UCSD-ECEMAE-148/148-winter-2025-final-project-team-11/markdown/image-6.png

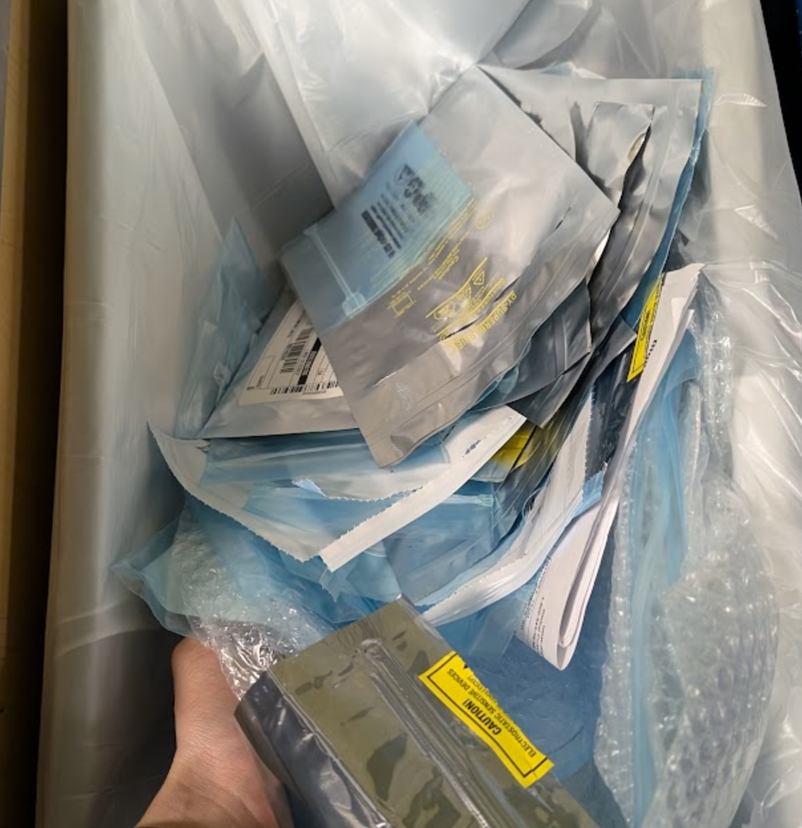
markdown/image-6.png
