UCSD-ECEMAE-148/148-winter-2025-final-project-team-11/markdown/image-10.png

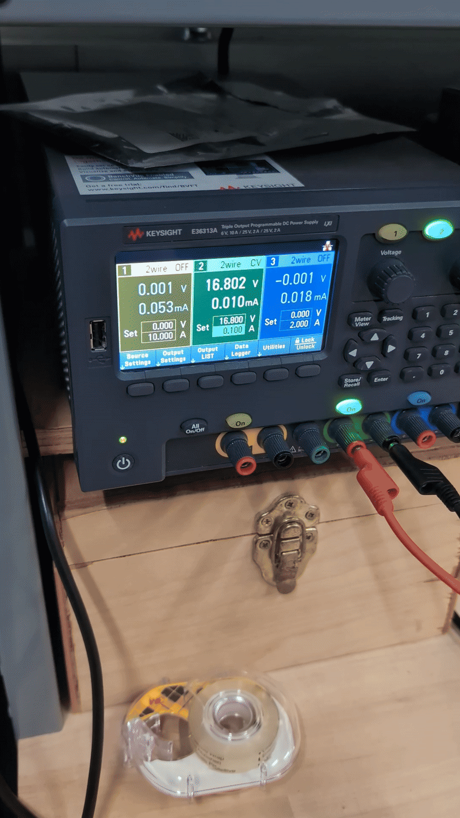
markdown/image-10.png
