UCSD-ECEMAE-148/148-winter-2025-final-project-team-11/ECE148_Mainboard_PCB/ECE148_Mainboard.kicad_pcb

## KiCad design ECE148_Mainboard_PCB/ECE148_Mainboard.kicad_pcb (2025-03-14)

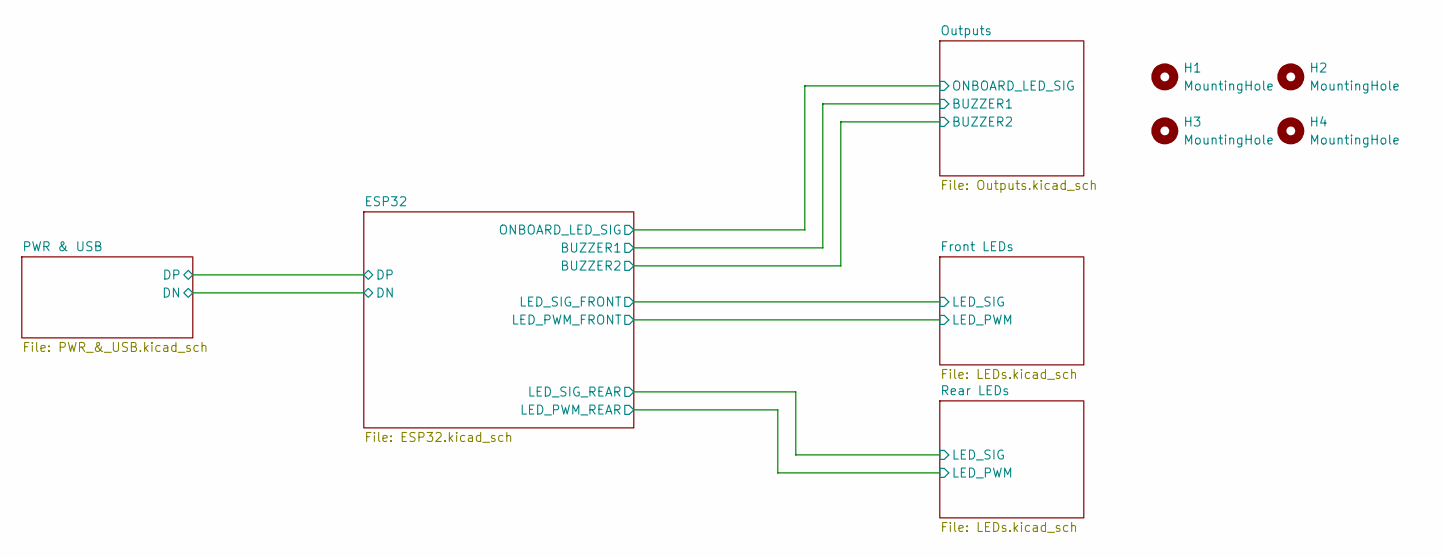
[picture p14: schematic ECE148_Mainboard.kicad_sch]

Parts:
H1, H2, H3, H4: MountingHole; MountingHole_3.2mm_M3

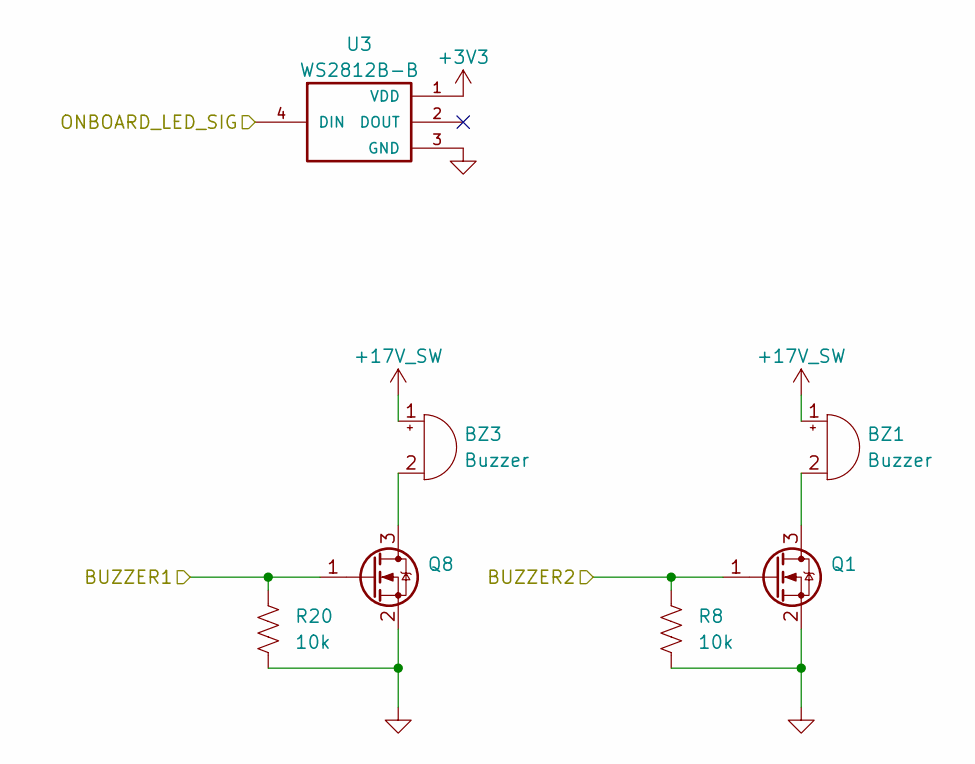
[picture p15: schematic Outputs.kicad_sch]

Parts:
BZ1, BZ3: Buzzer; Buzzer_12x9.5RM7.6
Q1, Q8: Q_NMOS_GSD; SOT-23
R8, R20: 10k; R_0402_1005Metric
U3: WS2812B-B; LED_WS2812B-B; PARTREV 5

Connections:
+3V3: U3.1 (VDD); also elsewhere on the board
+17V_SW: BZ1.1 (+), BZ3.1 (+); also elsewhere on the board
/ESP32/BUZZER1: Q8.1 (G), R20.1; also elsewhere on the board
/ESP32/BUZZER2: Q1.1 (G), R8.1; also elsewhere on the board
/ESP32/ONBOARD_LED_SIG: U3.4 (DIN); also elsewhere on the board
GND: Q1.2 (S), Q8.2 (S), R8.2, R20.2, U3.3 (GND); also elsewhere on the board
unnamed: BZ1.2 (-), Q1.3 (D)

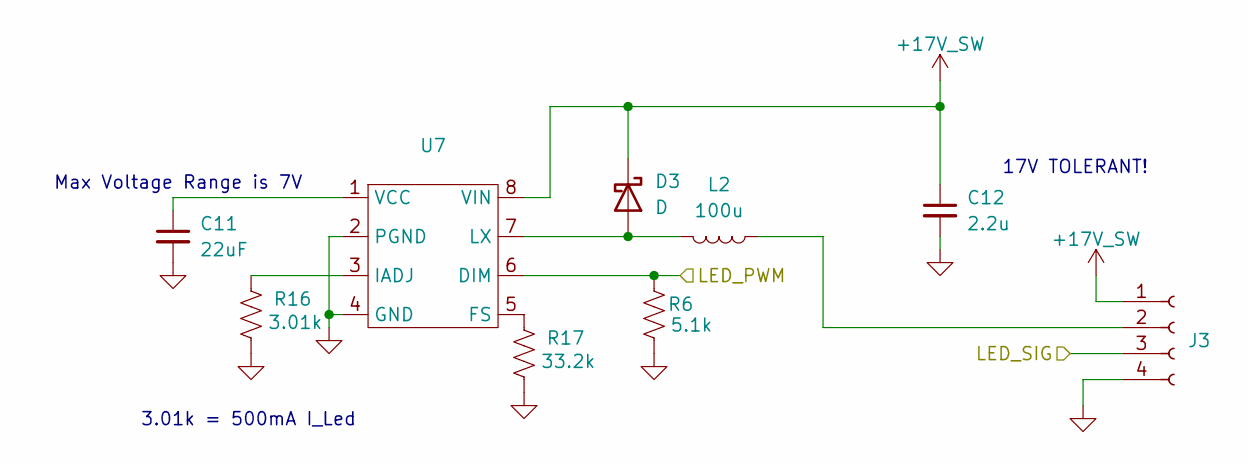
[picture p16: schematic LEDs.kicad_sch]

Parts:
C11: 22uF; C_0603_1608Metric
C12: 2.2u; C_0603_1608Metric
D3: D; D_SOD-123F
J3: Conn_01x05_Socket; JST_XH_B4B-XH-A_1x04_P2.50mm_Vertical
L2: 100u; L_Taiyo-Yuden_NR-60xx
R6: 5.1k; R_0402_1005Metric
R16: 3.01k; R_0402_1005Metric
R17: 33.2k; R_0402_1005Metric
U7: TI_SO-PowerPAD-8_ThermalVias

Connections:
+17V_SW: C12.1, D3.1 (K), J3.1, U7.8 (VIN); also elsewhere on the board
/ESP32/LED_PWM_FRONT: R6.1, U7.6 (DIM); also elsewhere on the board
/ESP32/LED_SIG_FRONT: J3.3; also elsewhere on the board
GND: C11.2, C12.2, J3.4, R6.2, R16.1, R17.1, U7.2 (PGND), U7.4 (GND), U7.9 (GND); also elsewhere on the board
unnamed: D3.2 (A), L2.2, U7.7 (LX)
unnamed: J3.2, L2.1
unnamed: R17.2, U7.5 (FS)
unnamed: R16.2, U7.3 (IADJ)
unnamed: C11.1, U7.1 (VCC)

Parts of its further copies:
C13: 22uF; C_0603_1608Metric
C14: 2.2u; C_0603_1608Metric
D4: D; D_SOD-123F
J12: Conn_01x05_Socket; JST_XH_B4B-XH-A_1x04_P2.50mm_Vertical
L3: 100u; L_Taiyo-Yuden_NR-60xx
R7: 5.1k; R_0402_1005Metric
R18: 3.01k; R_0402_1005Metric
R19: 33.2k; R_0402_1005Metric
U8: TI_SO-PowerPAD-8_ThermalVias

Connections of its further copies:
+17V_SW: C14.1, D4.1 (K), J12.1, U8.8 (VIN); also elsewhere on the board
/ESP32/LED_PWM_REAR: R7.1, U8.6 (DIM); also elsewhere on the board
/ESP32/LED_SIG_REAR: J12.3; also elsewhere on the board
GND: C13.2, C14.2, J12.4, R7.2, R18.1, R19.1, U8.2 (PGND), U8.4 (GND), U8.9 (GND); also elsewhere on the board
unnamed: D4.2 (A), L3.2, U8.7 (LX)
unnamed: J12.2, L3.1
unnamed: R19.2, U8.5 (FS)
unnamed: R18.2, U8.3 (IADJ)
unnamed: C13.1, U8.1 (VCC)

Notes on the sheet:
17V TOLERANT!
Max Voltage Range is 7V
3.01k = 500mA I_Led

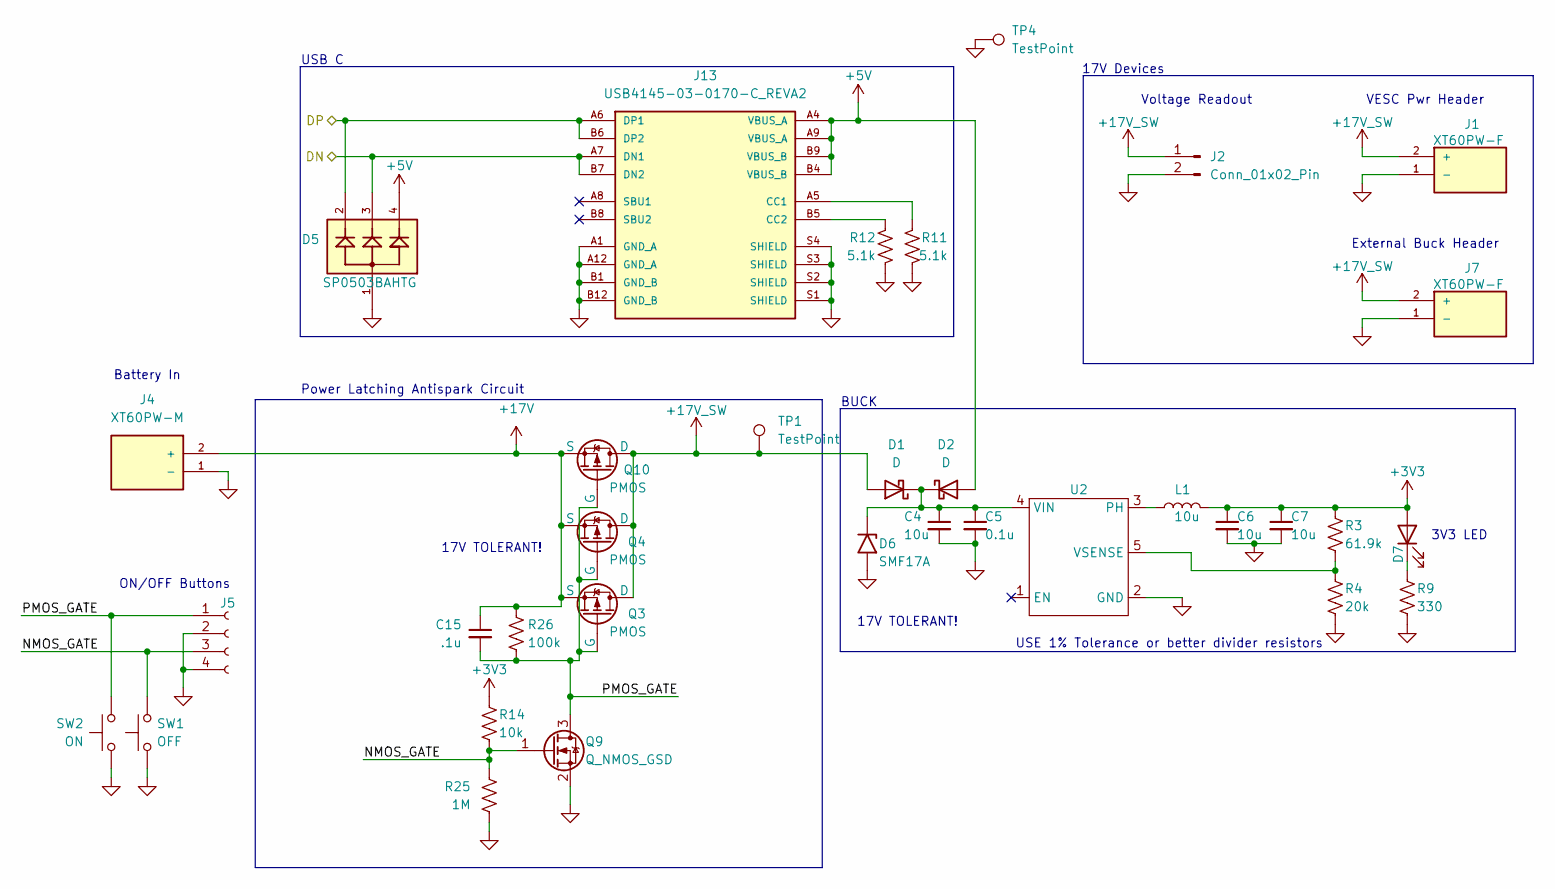
[picture p17: schematic PWR_&_USB.kicad_sch]

Parts:
C4, C6, C7: 10u; C_0805_2012Metric
C5: 0.1u; C_0402_1005Metric
C15: .1u; C_0402_1005Metric
D1, D2: D; D_SOD-123F
D5: SP0503BAHTG; SOT-143; PARTREV N/A
D6: SMF17A; D_SOD-123F
D7: LED; LED_0603_1608Metric
J1, J7: XT60PW-F; AMASS_XT60PW-F_1x02_P7.20mm_Horizontal; PARTREV V1.2
J2: Conn_01x02_Pin; PinHeader_1x02_P2.54mm_Vertical
J4: XT60PW-M; AMASS_XT60PW-M_1x02_P7.20mm_Horizontal; PARTREV V1.2
J5: Conn_01x04_Socket; PinHeader_1x04_P2.54mm_Vertical
J13: USB4145-03-0170-C_REVA2; GCT_USB4145-03-0170-C_REVA2; PARTREV A2
L1: 10u; L_Wurth_WE-LQSH-2010
Q3, Q4, Q10: PMOS; PowerPAK_SO-8_Single
Q9: Q_NMOS_GSD; SOT-23
R3: 61.9k; R_0402_1005Metric
R4: 20k; R_0402_1005Metric
R9: 330; R_0402_1005Metric
R11, R12: 5.1k; R_0402_1005Metric
R14: 10k; R_0402_1005Metric
R25: 1M; R_0402_1005Metric
R26: 100k; R_0402_1005Metric
SW1: OFF; SW_Push_1P1T_NO_Vertical_Wuerth_434133025816
SW2: ON; SW_Push_1P1T_NO_Vertical_Wuerth_434133025816
TP1, TP4: TestPoint; TestPoint_Pad_D1.5mm
U2: SOT-23-5

Connections:
+3V3: C6.1, C7.1, D7.2 (A), L1.2, R3.1, R14.1; also elsewhere on the board
+5V: D2.2 (A), D5.4, J13.A4 (VBUS_A), J13.A9 (VBUS_A), J13.B4 (VBUS_B), J13.B9 (VBUS_B)
+17V: C15.1, J4.2 (+), Q3.1 (S), Q3.2 (S), Q3.3 (S), Q4.1 (S), Q4.2 (S), Q4.3 (S), Q10.1 (S), Q10.2 (S), Q10.3 (S), R26.1
+17V_SW: D1.2 (A), J1.2 (+), J2.1, J7.2 (+), Q3.5 (D), Q4.5 (D), Q10.5 (D), TP1.1; also elsewhere on the board
/ESP32/DN: D5.3, J13.A7 (DN1), J13.B7 (DN2); also elsewhere on the board
/ESP32/DP: D5.2, J13.A6 (DP1), J13.B6 (DP2); also elsewhere on the board
/PWR & USB/NMOS_GATE: J5.3, Q9.1 (G), R14.2, R25.1, SW1.2
/PWR & USB/PMOS_GATE: C15.2, J5.1, Q3.4 (G), Q4.4 (G), Q9.3 (D), Q10.4 (G), R26.2, SW2.1
GND: C4.2, C5.2, C6.2, C7.2, D5.1, D6.2 (A2), J1.1 (-), J2.2, J4.1 (-), J5.2, J5.4, J7.1 (-), J13.A1 (GND_A), J13.A12 (GND_A), J13.B1 (GND_B), J13.B12 (GND_B), J13.S1 (SHIELD), J13.S2 (SHIELD), J13.S3 (SHIELD), J13.S4 (SHIELD), Q9.2 (S), R4.2, R9.2, R11.2, R12.2, R25.2, SW1.1, SW2.2, TP4.1, U2.2 (GND); also elsewhere on the board
unnamed: C4.1, C5.1, D1.1 (K), D2.1 (K), D6.1 (A1), U2.4 (VIN)
unnamed: D7.1 (K), R9.1
unnamed: J13.A5 (CC1), R11.1
unnamed: J13.B5 (CC2), R12.1
unnamed: L1.1, U2.3 (PH)
unnamed: R3.2, R4.1, U2.5 (VSENSE)

Notes on the sheet:
Battery In
BUCK
3V3 LED
VESC Pwr Header
USE 1% Tolerance or better divider resistors
Power Latching Antispark Circuit
17V TOLERANT!
USB C
External Buck Header
Voltage Readout
17V Devices
ON/OFF Buttons

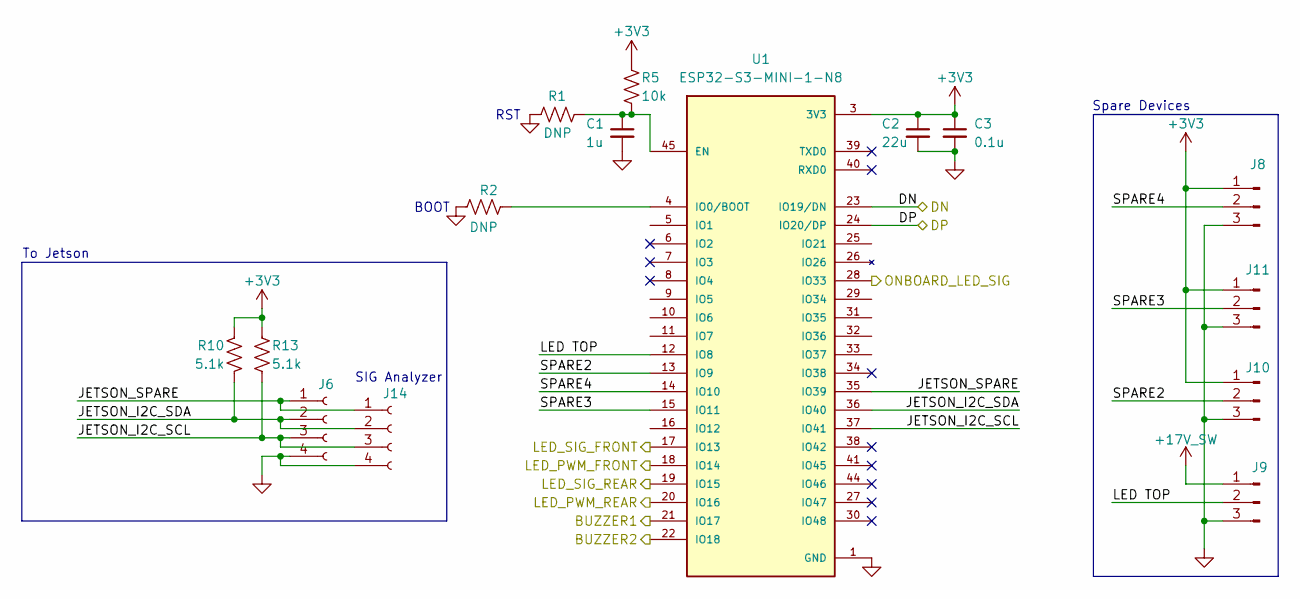
[picture p18: schematic ESP32.kicad_sch]

Parts:
C1: 1u; C_0402_1005Metric
C2: 22u; C_0603_1608Metric
C3: 0.1u; C_0402_1005Metric
J6: Conn_01x04_Socket; JST_XH_B4B-XH-A_1x04_P2.50mm_Vertical
J8, J9, J10, J11: Conn_01x03_Pin; PinHeader_1x03_P2.54mm_Vertical
J14: Conn_01x04_Socket; PinHeader_1x04_P2.54mm_Vertical
R1, R2: DNP; R_0402_1005Metric
R5: 10k; R_0402_1005Metric
R10, R13: 5.1k; R_0402_1005Metric
U1: ESP32-S3-MINI-1-N8; XCVR_ESP32-S3-MINI-1-N8; PARTREV v0.6

Connections:
+3V3: C2.1, C3.1, J8.1, J10.1, J11.1, R5.1, R10.1, R13.1, U1.3 (3V3); also elsewhere on the board
+17V_SW: J9.1; also elsewhere on the board
/ESP32/BUZZER1: U1.21 (IO17); also elsewhere on the board
/ESP32/BUZZER2: U1.22 (IO18); also elsewhere on the board
/ESP32/DN: U1.23 (IO19/DN); also elsewhere on the board
/ESP32/DP: U1.24 (IO20/DP); also elsewhere on the board
/ESP32/JETSON_I2C_SCL: J6.3, J14.3, R13.2, U1.37 (IO41)
/ESP32/JETSON_I2C_SDA: J6.2, J14.2, R10.2, U1.36 (IO40)
/ESP32/JETSON_SPARE: J6.1, J14.1, U1.35 (IO39)
/ESP32/LED TOP: J9.2, U1.12 (IO8)
/ESP32/LED_PWM_FRONT: U1.18 (IO14); also elsewhere on the board
/ESP32/LED_PWM_REAR: U1.20 (IO16); also elsewhere on the board
/ESP32/LED_SIG_FRONT: U1.17 (IO13); also elsewhere on the board
/ESP32/LED_SIG_REAR: U1.19 (IO15); also elsewhere on the board
/ESP32/ONBOARD_LED_SIG: U1.28 (IO33); also elsewhere on the board
/ESP32/SPARE2: J10.2, U1.13 (IO9)
/ESP32/SPARE3: J11.2, U1.15 (IO11)
/ESP32/SPARE4: J8.2, U1.14 (IO10)
GND: C1.2, C2.2, C3.2, J6.4, J8.3, J9.3, J10.3, J11.3, J14.4, R1.1, R2.1, U1.1 (GND), U1.2 (GND), U1.42 (GND), U1.43 (GND), U1.46 (GND), U1.47 (GND), U1.48 (GND), U1.49 (GND), U1.50 (GND), U1.51 (GND), U1.52 (GND), U1.53 (GND), U1.54 (GND), U1.55 (GND), U1.56 (GND), U1.57 (GND), U1.58 (GND), U1.59 (GND), U1.60 (GND), U1.61 (GND), U1.61_1 (GND), U1.61_2 (GND), U1.61_3 (GND), U1.61_4 (GND), U1.61_5 (GND), U1.61_6 (GND), U1.61_7 (GND), U1.61_8 (GND), U1.62 (GND), U1.63 (GND), U1.64 (GND), U1.65 (GND); also elsewhere on the board
unnamed: C1.1, R1.2, R5.2, U1.45 (EN)
unnamed: R2.2, U1.4 (IO0/BOOT)

Notes on the sheet:
BOOT
SIG Analyzer
Spare Devices
RST
To Jetson

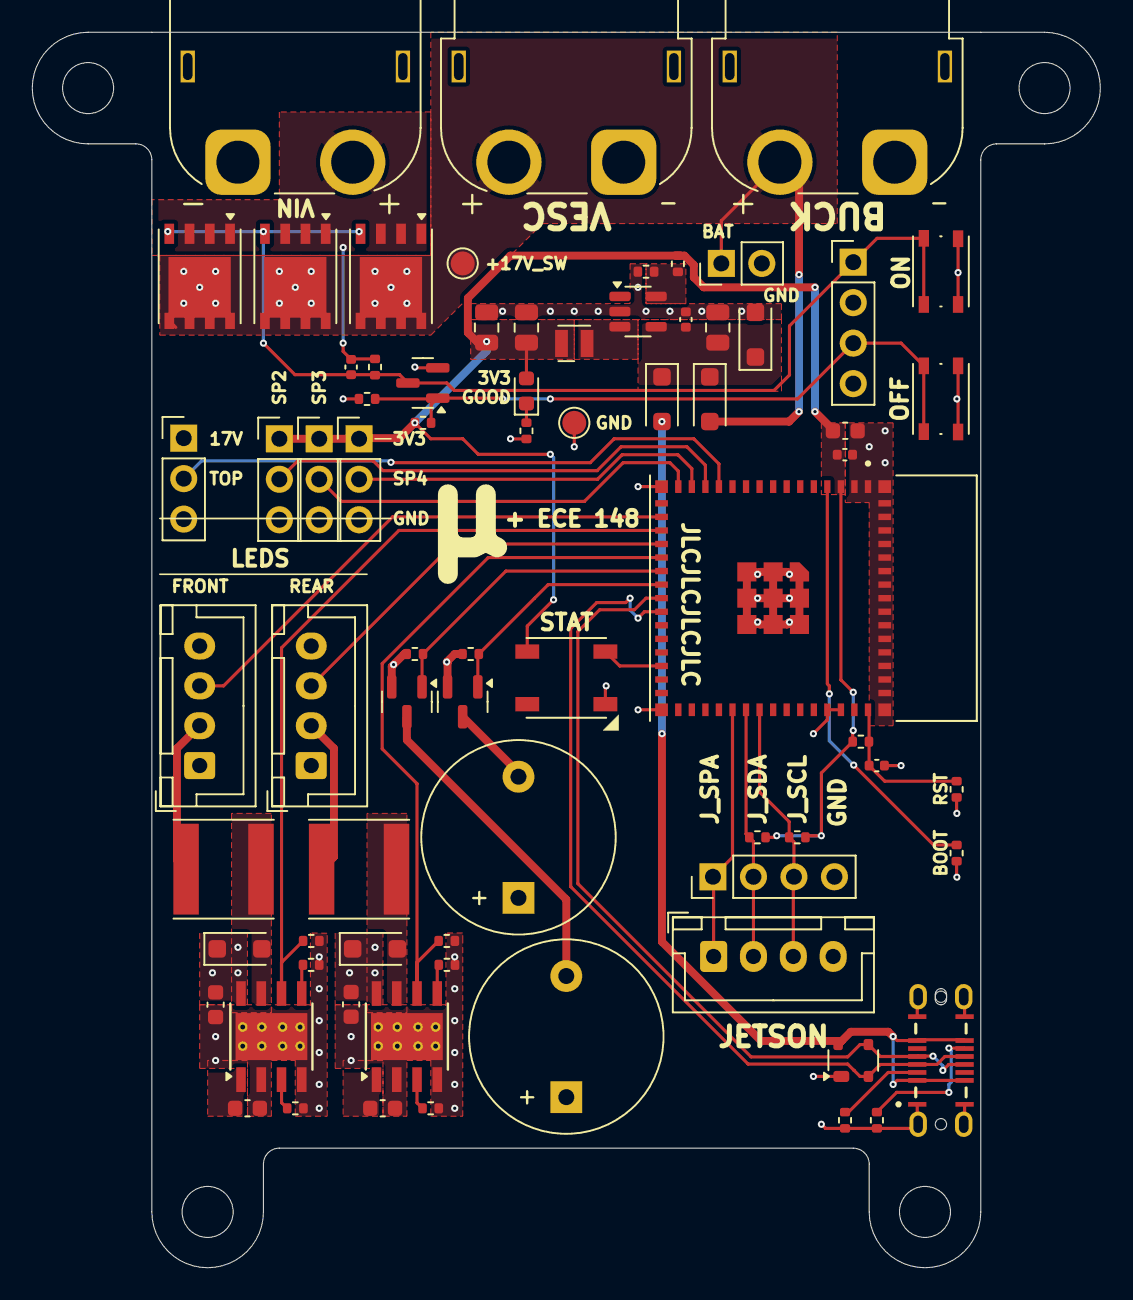
[picture p19: board ECE148_Mainboard.kicad_pcb from above]

Board: 4 copper layers, 67.0 x 77.5 mm, 78 parts (0 on the bottom side), 42 nets.
