UCSD-ECEMAE-148/148-winter-2025-final-project-team-11/ECE148-ESP32-S3-Platformio/include/pindefinitions.h

#define LED_TOP 8
#define ONBOARD_LED 33
#define LED_SIG_FRONT 13
#define LED_PWM_FRONT 14
#define LED_SIG_REAR 15
#define LED_PWM_REAR 16
#define BUZZER1 17
#define BUZZER2 18

#define NUM_LEDS 11

#define JETSON_SPARE 39
#define JETSON_I2C_SDA 40
#define JETSON_I2C_SCL 41
